gaoajia/Graduation/Image/图3-6PCB实物图.jpg

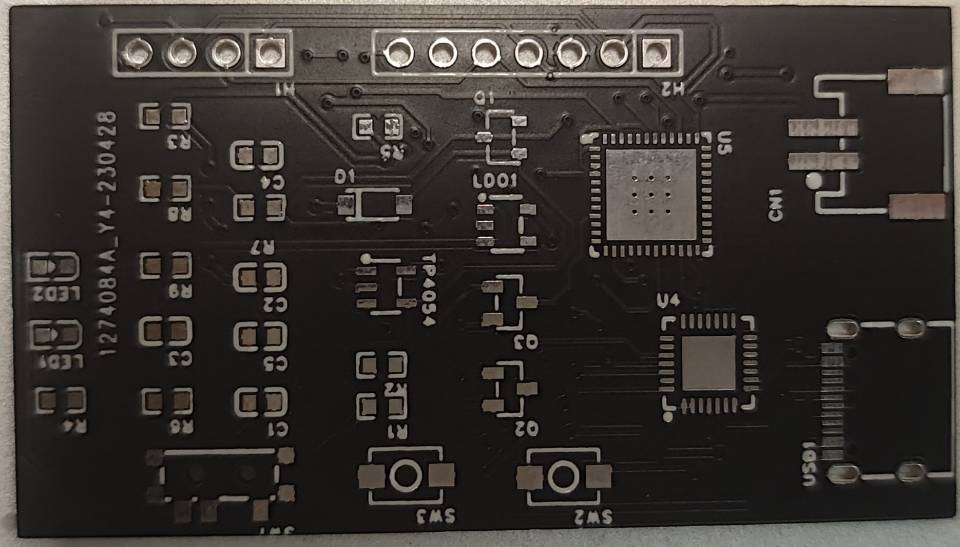
Image/图3-6PCB实物图.jpg
