gaoajia/Graduation/Image/图3-8实物图.jpg

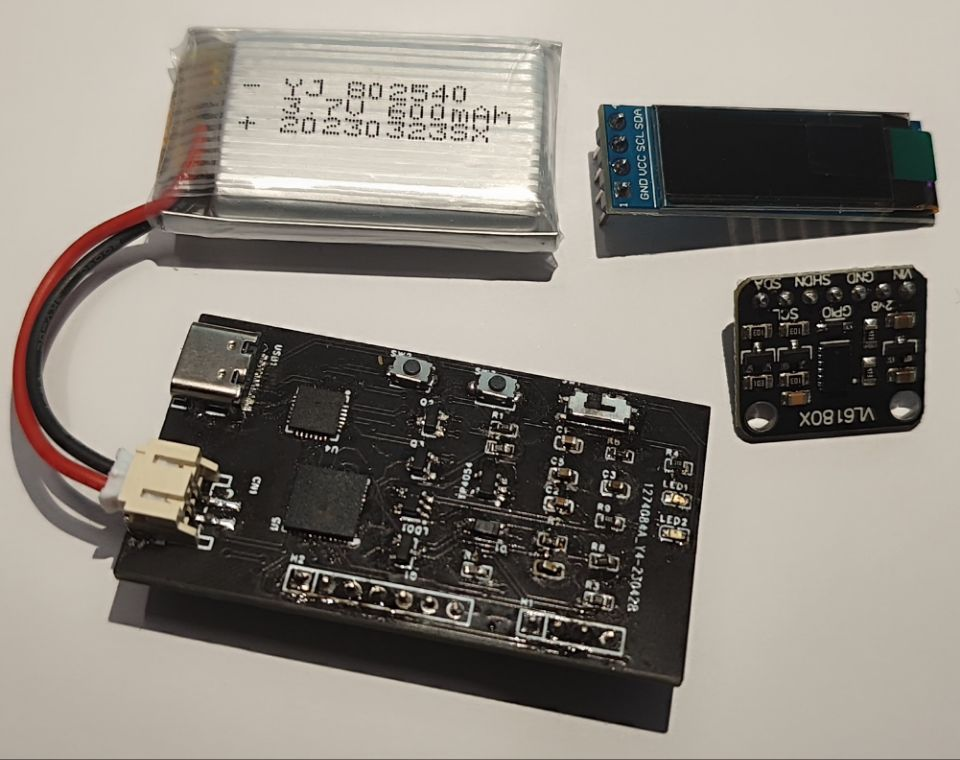
Image/图3-8实物图.jpg
