gaoajia/Graduation/README.md

# Graduation

### 本设计所用的操作系统及软件版本：

- Linux 6.3.1-zen
- WPS - 正式版 v11.1.0.11698-release
- PlatformIO Core 6
- vsCode 1.78.0 x64
- ESP-IDF  v5.0.2
- gcc (GCC) 13.1.1 20230429
- cmake version 3.26.3
- 嘉立创EDA(专业版) V2.0.21
- Python 3.11.3

### 项目目录

```
.
├── code
│   ├── include
│   ├── lib
│   │   └── VL6180_WE
│   │       ├── VL6180X.cpp
│   │       └── VL6180X.h
│   ├── platformio.ini
│   ├── src
│   │   └── main.cpp
│   └── test
│       └── jingdu.py
├── hardware
│   ├── BOM清单.xlsx
│   ├── VL6180_backup
│   └── VL6180.eprj
├── README.md
└── Thesis
    └── 毕业论文.docx
```
