gaoajia/Graduation/Image/图2-1ToF原理.png

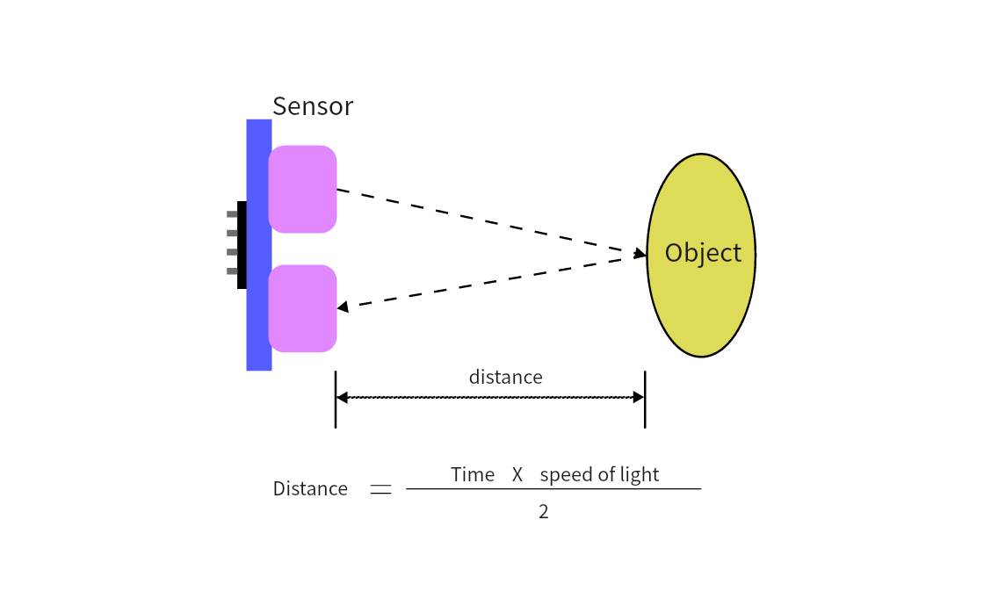
Image/图2-1ToF原理.png
