gaoajia/Graduation/Image/图3-1双路电源及稳压.png

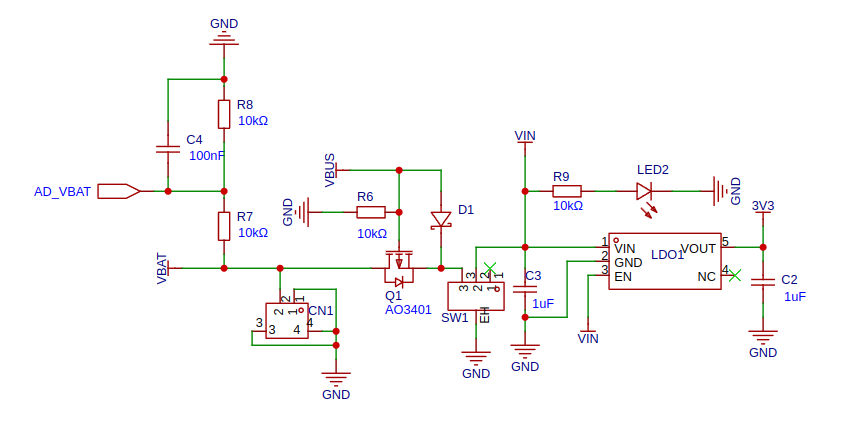
Image/图3-1双路电源及稳压.png
