gaoajia/Graduation/Image/图3-4VL6180驱动电路.png

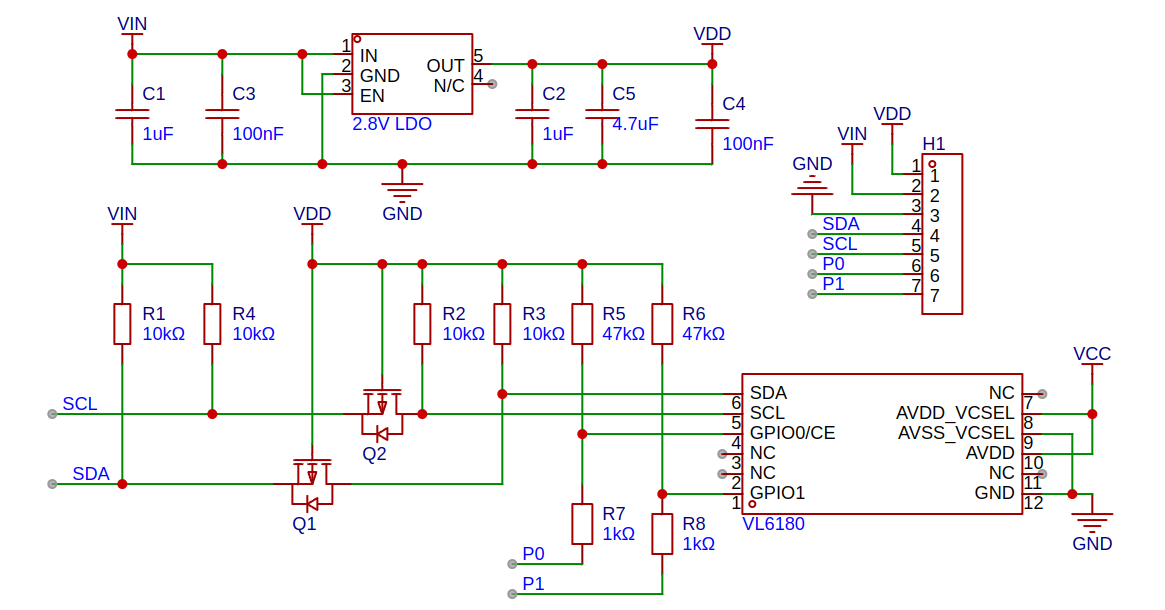
Image/图3-4VL6180驱动电路.png
