gaoajia/Graduation/Image/图3-5其他电路.png

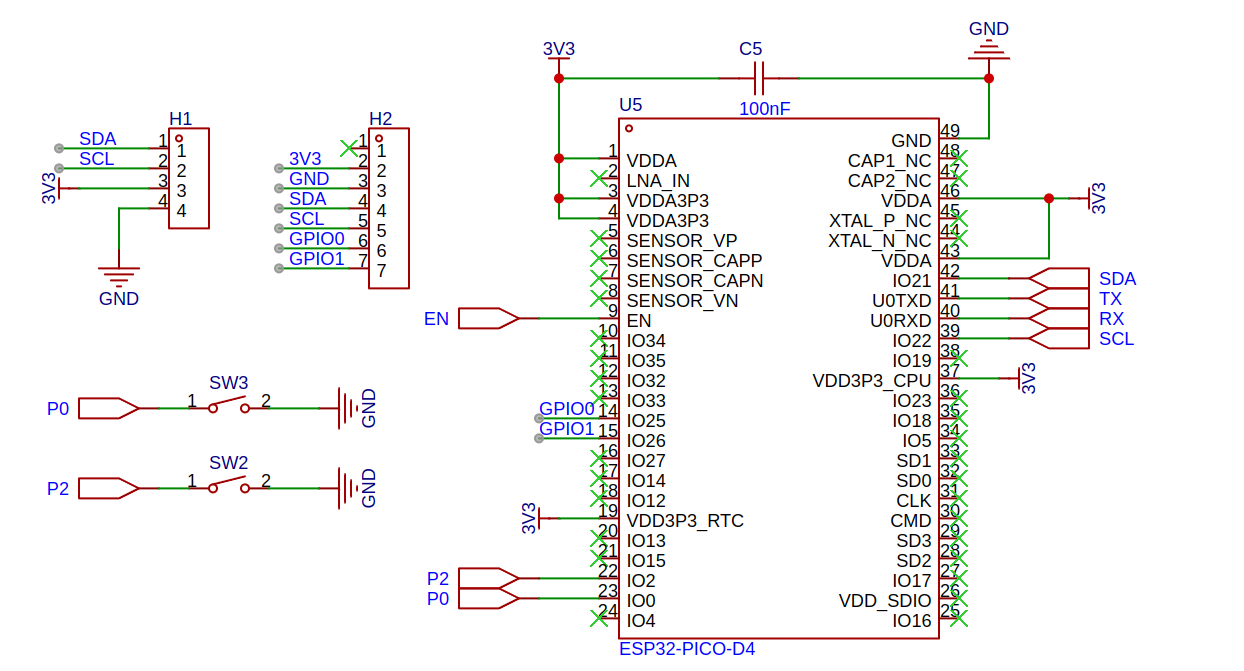
Image/图3-5其他电路.png
