gaoajia/Graduation/Image/图4-1散点图.png

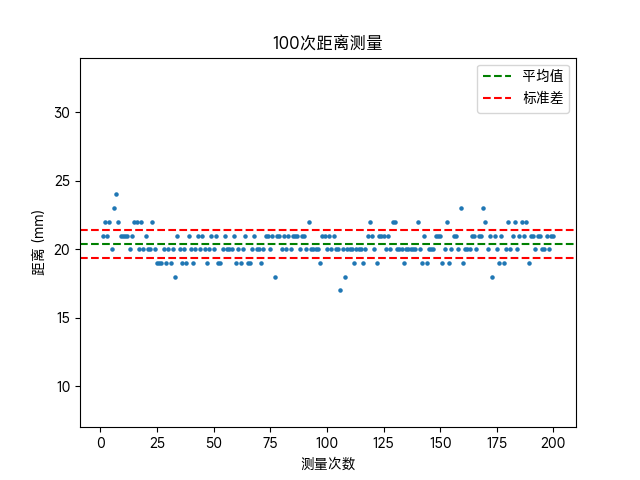
Image/图4-1散点图.png
