gaoajia/Graduation/Image/附录一VL6180驱动板.png

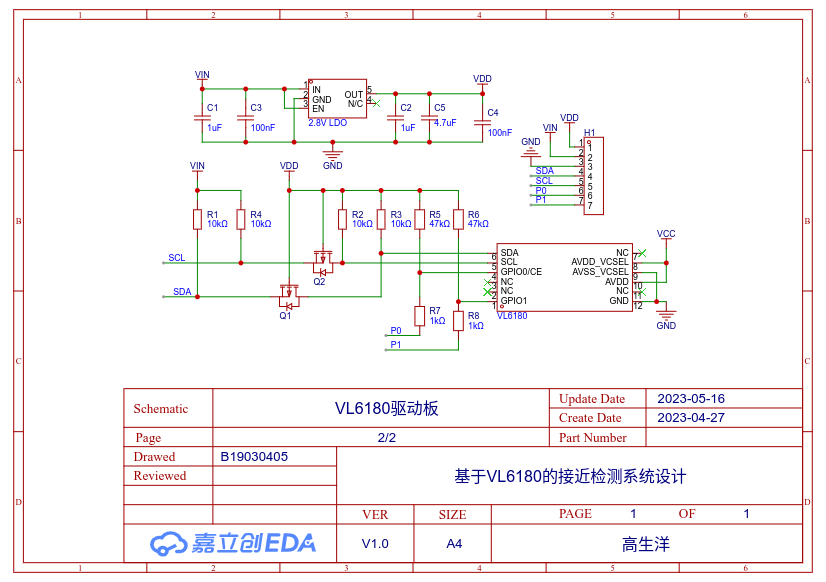
Image/附录一VL6180驱动板.png
