gaoajia/Graduation/Image/附录一主控电路.png

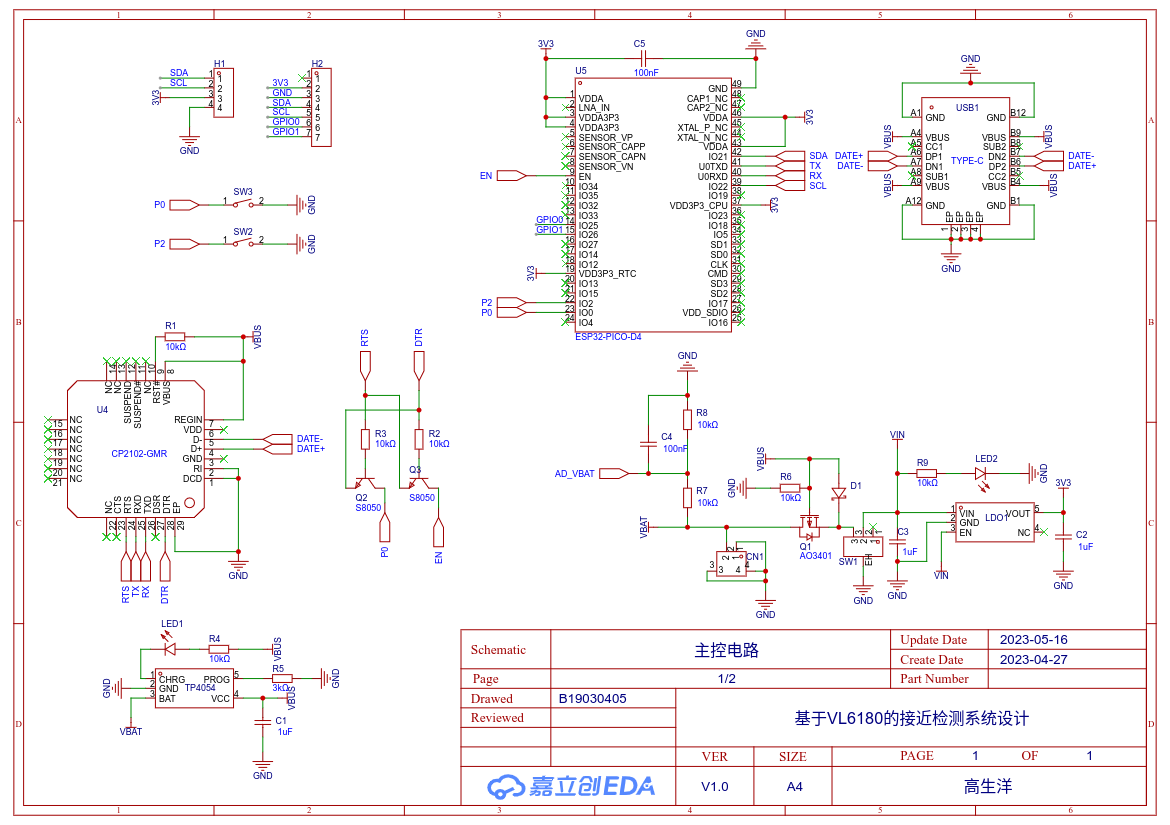
Image/附录一主控电路.png
