gaoajia/Graduation/hardware/VL6180驱动板.pdf

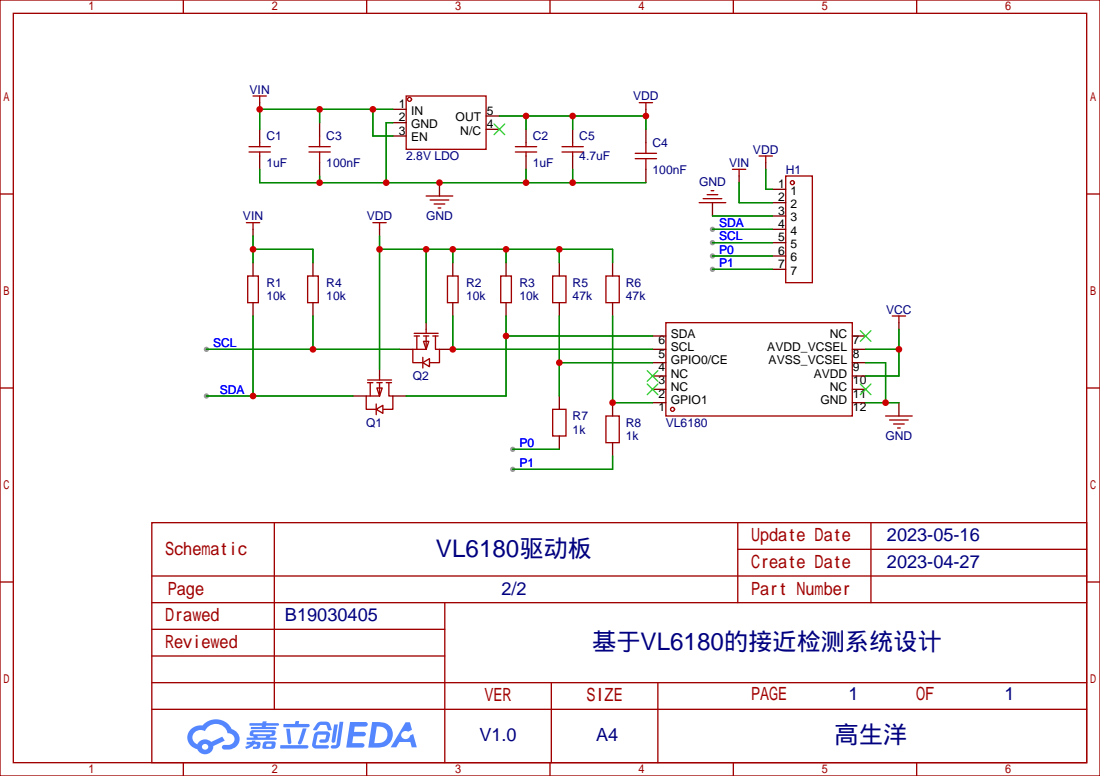
[picture p25: page 1]
