gaoajia/Graduation/hardware/主控电路.pdf

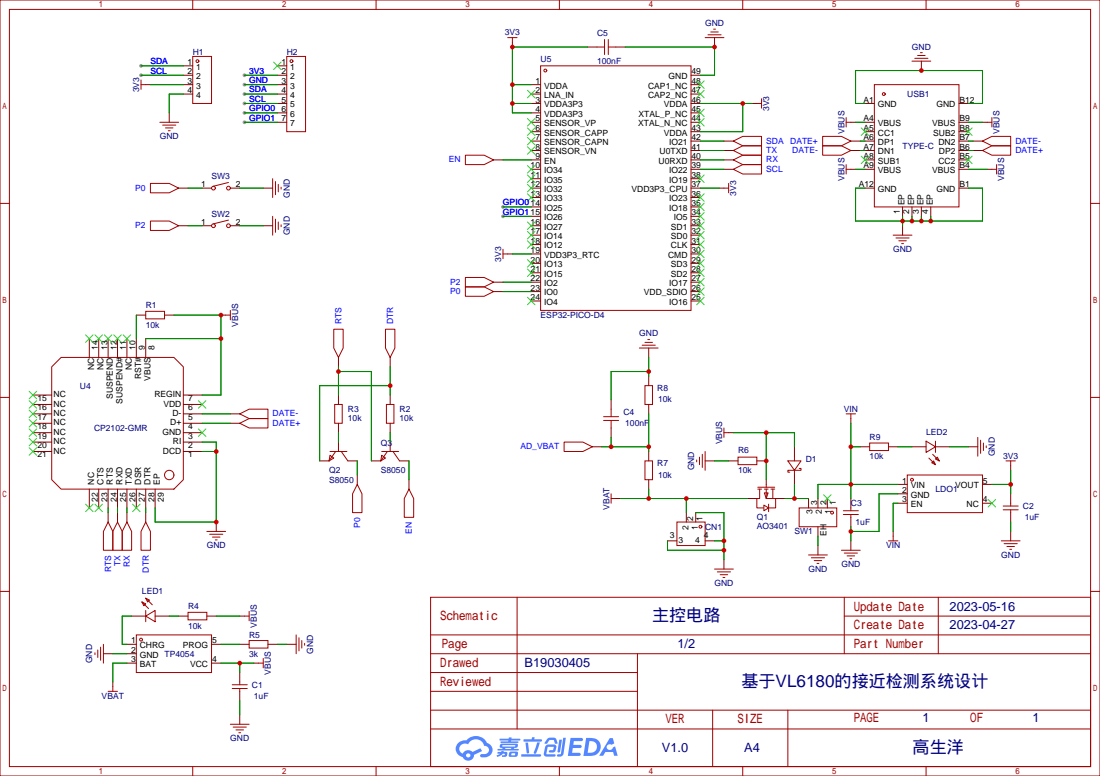
[picture p26: page 1]

SUSPEND 12

NC 22 CTS 23 RTS 24 RXD 25 TXD 26 DSR 27 DTR 28 EP 29
