gaoajia/Graduation/(list of files, drawings)

Other design files:
hardware/基于VL6180的接近检测系统设计.eprj
